deshanudara144-ui/Analog-Electronics-Project/Images/Final_Product.jpg

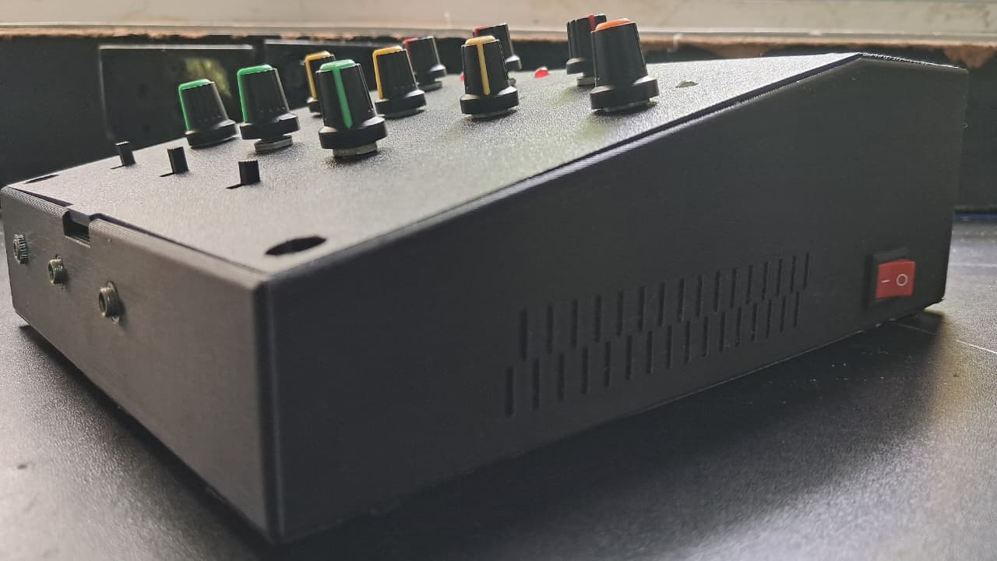
Images/Final_Product.jpg
