deshanudara144-ui/Analog-Electronics-Project/Images/PCB.jpg

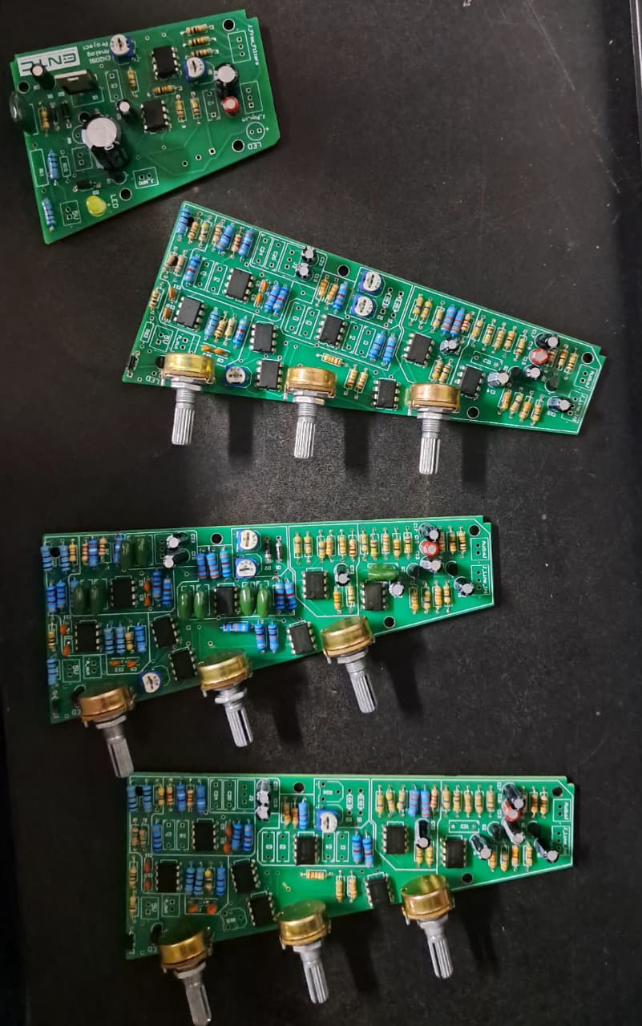
Images/PCB.jpg
