deshanudara144-ui/Analog-Electronics-Project/README.md

# 3-channel-audio-mixer
3 Channel Audio Mixer with 3 Band Equalizer – Electronics Engineering Project
# 3 Channel Audio Mixer with 3 Band Equalizer

This project presents the design and implementation of a 3 Channel Audio Mixer with a 3 Band Equalizer.

## Features
- Independent bass, mid, and treble control per channel
- Active RC filter-based equalization
- Operational amplifier based design
- Instrument and microphone input support
- Line-level audio output

## Applications
- Studio audio shaping
- Live sound systems
- Educational electronics projects

## Technologies Used
- Analog Electronics
- Operational Amplifiers
- Active Filters
- Audio Signal Processing

## Author
Udara Deshan  
BSc in Electronics Engineering  
University of Moratuwa
