deshanudara144-ui/Analog-Electronics-Project/Report/EN2091_Analog_project_Report.pdf

Department of Electronic & Telecommunication Engineering, University of Moratuwa, Sri Lanka.

# Three Channel Audio Mixer with Equalizers

Group Members:

Member 1 230130E | Deshan W.U.
Member 2 230138K | Dhananjaya K.T.G.T.N.
Member 3 230155J | Dissanaka D.M.D.P.
Member 4 230449N | Nuwanaka W.A.S.

Submitted in partial fulfillment of the requirements for the module EN 2091 Laboratory Practice and Projects

Date: December 14, 2025

Three Channel Audio Mixer with Equalizers | Circuit Pirates

Abstract
This project presents a compact analog audio mixer featuring three independent input channels, each equipped with a dedicated three-band equalizer—Bass (20–250 Hz), Mid (250 Hz–4 kHz), and Treble (4–20 kHz). The system enables precise tonal shaping of each channel through variable gain control stages, allowing users to amplify or attenuate specific frequency ranges according to acoustic needs. Signal processing is implemented using low-noise operational amplifiers (NE5532 and TL072), while the TDA2030A provides robust output amplification. BC547 transistors are employed for pre amplification. The mixer’s compact PCB layout ensures efficient signal routing and minimal footprint, making it suitable for portable and space-constrained applications. This design demonstrates practical applications of analog circuit principles, including multi-band filter design, signal mixing, component-level optimization, and system integration for real-world audio enhancement.

## Abbreviations and Acronyms

OpAmp Operational Amplifier

PCB Printed Circuit board

THD Total Harmonic Distortion

JFET Junction Field Effect Transistor

SNR Signal to noise ratio

1

## Contents

1 Introduction and Functionality | 3
2 System Architecture | 3
3 Component Selection | 7
4 PCB Design | 8
5 Enclosure Design | 10
6 Software Simulation and Hardware Testing | 12
7 Conclusion & Future Works | 14
8 Contribution of Group Members | 15

2

## 1 Introduction and Functionality

With the rapid growth of content creation among entry-level artists and the general public, the demand for compact, lightweight, and cost-effective audio mixers has increased significantly. Professional-grade sound mixers, although highly capable, are often expensive and bulky, making them unsuitable for beginners and small-scale applications.
To address this limitation, there is a growing need for portable and user-friendly audio mixing devices that offer essential audio processing features without excessive complexity. Audio mixers play a vital role in combining multiple audio sources and adjusting signal levels to achieve balanced and high-quality sound output.
The Three Channel Audio Mixer with Equalizers, developed by Circuit Pirates, is designed to fulfill this requirement. The system enables users to mix three independent audio inputs while providing equalization control to adjust low, mid, and high frequency components. This makes the mixer suitable for applications such as music recording, podcast production, live streaming, and educational audio experiments, where simplicity, affordability, and performance are equally important.

## 2 System Architecture

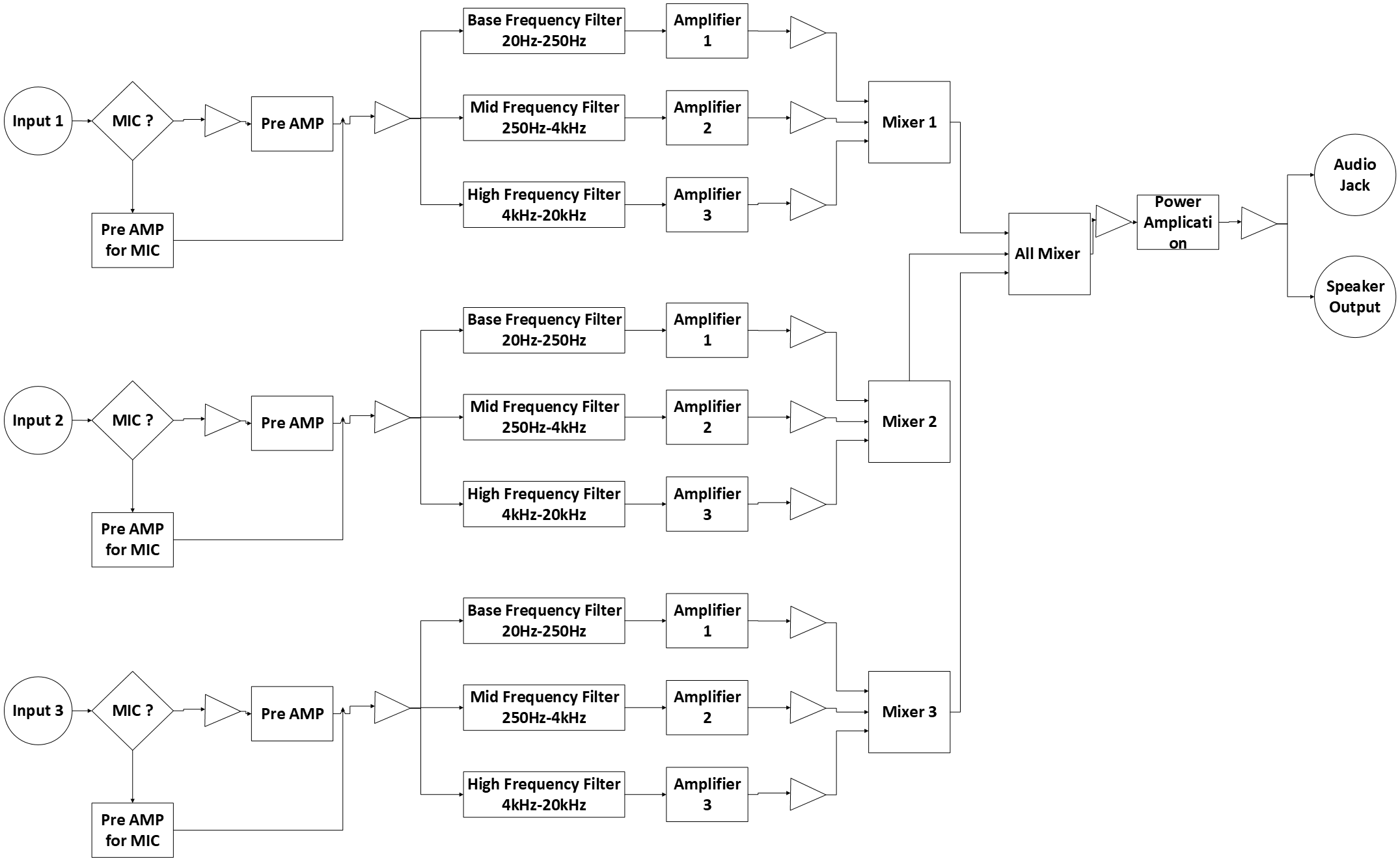
[picture p4: figure]

Figure 1: Example Figure.

### 2.1 Pre Amplifier

Mic Pre-amplifier

For the mic pre-amplifier we used a cascaded transistor based amplifier in common emitter configuration with voltage divider bias.This ensured the thermal stability and the preferred gain.(gain 160) Moderate input impedance and high output impedance was required by the mic input, this BJT configuration ensured these needs.

3

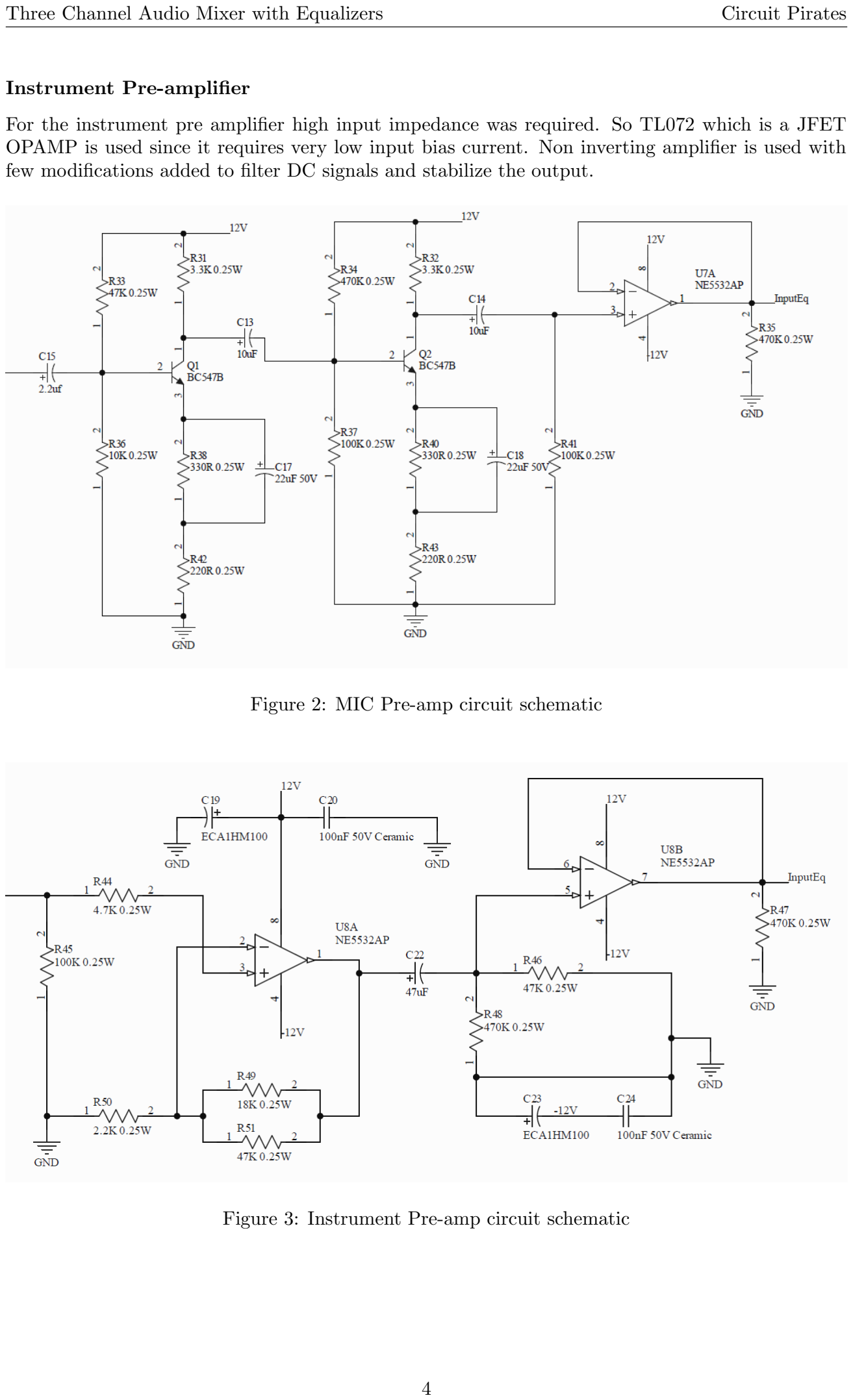
[picture p5: page 5]

Instrument Pre-amplifier

For the instrument pre amplifier high input impedance was required. So TL072 which is a JFET OPAMP is used since it requires very low input bias current. Non inverting amplifier is used with few modifications added to filter DC signals and stabilize the output.

Figure 2: MIC Pre-amp circuit schematic

Figure 3: Instrument Pre-amp circuit schematic

4

### 2.2 Equalizers

Unity gain band-pass filters are implemented by cascading a second-order Sallen–Key low-pass filter with a second-order Sallen–Key high-pass filter. This configuration enables independent adjustment of the lower and upper cutoff frequencies, thereby providing flexible control over the passband characteristics.

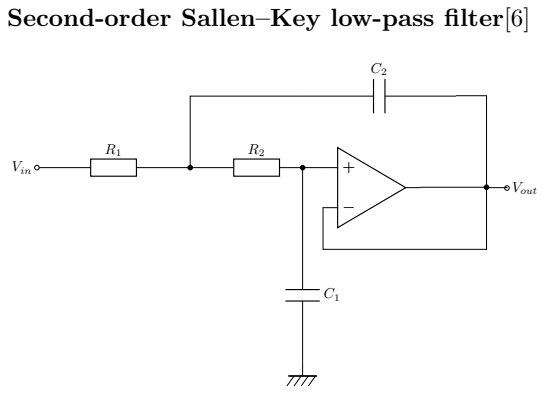
[picture p6: figure]
Second-order Sallen–Key low-pass filter[6]; Vin; Vout

Figure 4: Sallen–Key low-pass filter

- Cut-off frequency: fc =
1
2π

√
R1R2C1C2
- Dumping factor: ζ =
R1+R2
2

q C1

C2R1R2

- Filter quality: Q =
ζ
2

By selecting R1 = R2 = R and C1 = C2 = C, the cutoff frequency simplifies to

fc =

1
2πRC .

Furthermore, under these conditions, the damping factor is ζ = 1, corresponding to a critically damped response, and the quality factor is Q = 0.5.

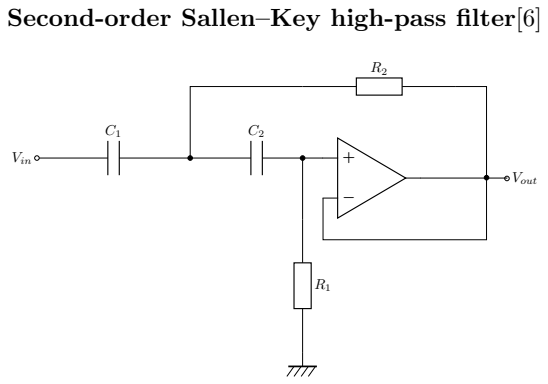
[picture p7: figure]
Second-order Sallen–Key high-pass filter[6]; Vin; Vout

Figure 5: Sallen–Key high-pass filter

- Cut-off frequency: fc =
1
2π

√
R1R2C1C2
- Dumping factor: ζ =
C1+C2
2

q R2

R1C1C2

- Filter quality: Q =
ζ
2

Similar to the low-pass filter, by selecting R1 = R2 = R and C1 = C2 = C, the cutoff frequency of the high-pass filter simplifies to

fc =

1
2πRC .

Then again, under these conditions, the damping factor is ζ = 1, corresponding to a critically damped response, and the quality factor is Q = 0.5.

The above high-pass and low-pass filters are cascaded to form the unity gain band-pass filter.

5

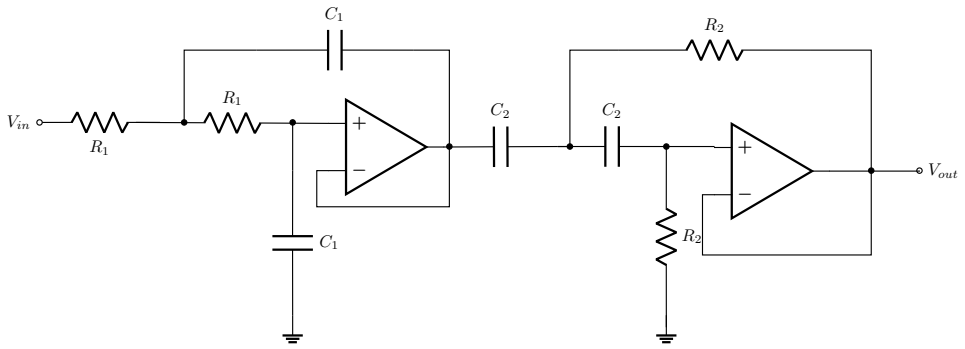
[picture p8: figure]
C2 Vin; Vout

Figure 6: Unity-Gain Sallen-Key Band-Pass Filter

Calculated Theoretical Resistor & Capacitor Values for Band-pass Filters

Frequency band | Low pass filter | High pass filter
| R1 C1 | R2 C2
Low frequency band (50 Hz – 250 Hz) | 6.2 kΩ 100 nF | 33 kΩ 100 nF
Mid frequency band (250 Hz – 4 kHz) | 3.9 kΩ 10 nF | 6.2 kΩ 100 nF
High frequency band (4 kHz – 20 kHz) | 820 Ω 10 nF | 3.9 kΩ 10 nF

Table 1: Component values for band-pass filters

However, slight variations were observed between the practical resistor and capacitor values and the theoretically calculated values, primarily due to component tolerances.

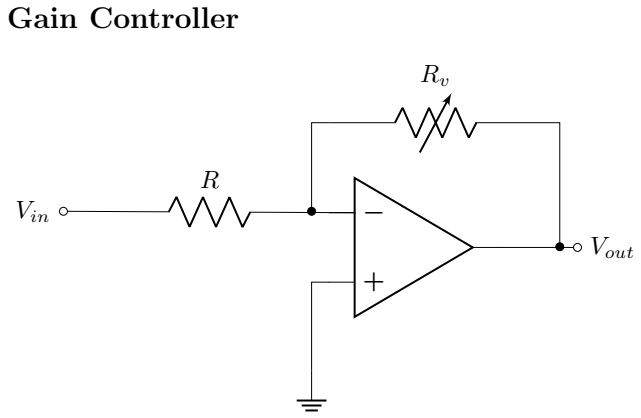
[picture p9: figure]
Gain Controller; Vin; Vout

figure: Gain Controller

Vin − 0
R

=

0 − Vout
Rv

Vout =

Rv
R

Vin

6

### 2.3 Power Amplifier Design

The power amplifier circuit was taken from the datasheet of the TDA2030A IC by ST Microelectronics.[5]

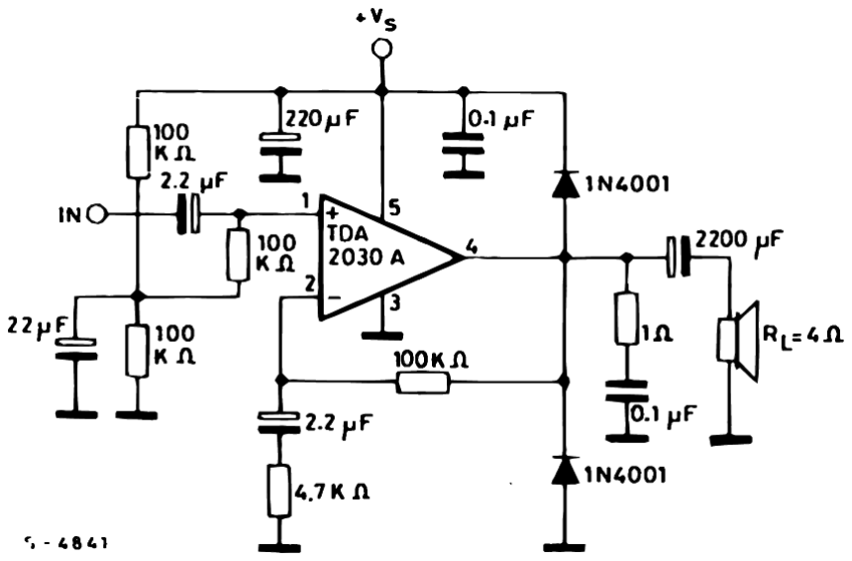
[picture p10: figure]

Figure 7: Power apmplifier circuit design.

### 2.4 Power supply

12V dual supply was designed. Additionally coupling capacitors were added to remove the ripple.

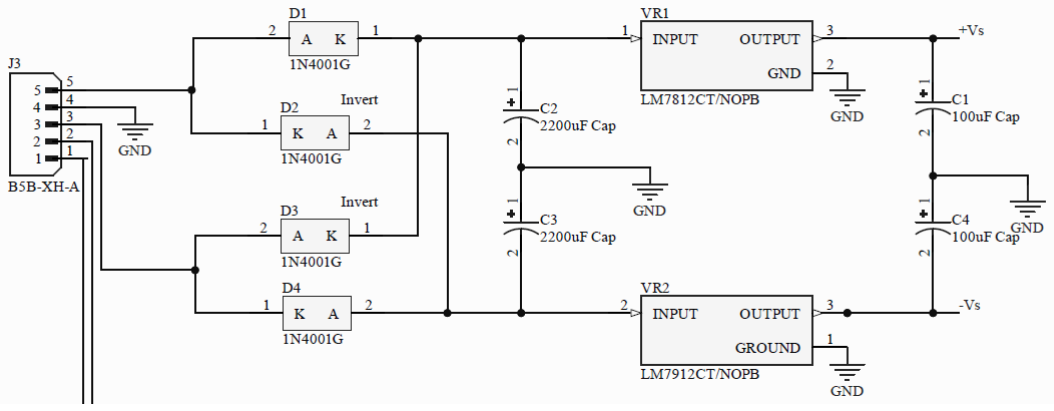
[picture p11: figure]

Figure 8: Power supply circuit design.

## 3 Component Selection

1. BC547B NPN Transistor (Audio Applications) [4]
- Low Noise BJT: Suitable for small-signal audio preamplifiers
- Low Input Noise Current: Ideal for microphone and sensor front-ends
- High Gain (hFE): 200–450 typical for clean signal amplification
- Low Distortion: Works well in linear amplifier stages
- Collector Current: Up to 100 mA for small audio drivers
- Common Use: Input stages, tone controls, preamp gain blocks

7

2. NE5532 Dual Low-Noise Audio Operational Amplifier [3]
- Ultra-Low Noise: 5 nV/√
Hz for high-fidelity audio
- Low THD: 0.0005% typical for clean reproduction
- High Slew Rate: 9 V/µs supports wide dynamic range
- Wide Bandwidth: 10 MHz GBW for full audio spectrum accuracy
- High Output Drive: Can directly drive 600 Ω loads
- Common Use: Headphone amps, mixers, equalizers, DAC/ADC buffers
3. TL072 JFET-Input Audio Operational Amplifier [2]
- JFET Inputs: Very high input impedance for guitar/piezo pickups
- Low Noise: 15 nV/√
Hz suitable for musical instrument preamps
- High Slew Rate: 16 V/µs for fast transient response
- Low Distortion: 0.01% typical across audio band
- Warm JFET Sound: Preferred in analog synths and guitar pedals
- Common Use: Tone shaping, buffers, active filters, effects pedals
4. TDA2030A Class-AB Audio Power Amplifier [5]
- Output Power: Up to 20W for compact speaker systems
- Low THD: Very low harmonic and crossover distortion
- High Output Current: Drives 4 Ω and 8 Ω speakers
- Wide Frequency Response: Suitable for full-range audio
- Stable Class-AB Operation: Smooth, warm analog sound
- Common Use: Active speakers, subwoofer modules, DIY amplifiers

## 4 PCB Design

We implemented a modular approach where we used 3 separate PCB s for the channels and a single PCB to combine and power amplify the signal. The power supply was made as a separate PCB to reduce the power supply noise interference with audio.

Signal Integrity and Noise Reduction

The PCB layout was created with a focus on reducing noise and maintaining signal integrity. Sensitive input paths were routed away from switching or high-current nodes, and low-level audio traces were kept as brief as possible to minimize interference.

Grounding Strategy

To avoid ground loops and get a clear audio performance, a star-ground strategy was used. Analog grounds for each channel were separated throughout the board and joined only at a single point.

Power Supply and Decoupling

Each channel was provided with local decoupling capacitors, combining 100 nF ceramic capacitors for high-frequency filtering and 10 µF electrolytic capacitors for reducing low-frequency voltage ripple. The power supply section was physically isolated from the audio signal paths, ensuring clean ±12 V rails for the mixer.

8

Component Placement and Routing

In order to support both mechanical usability and electrical performance, component placement was optimised. To reduce loop area, op-amps were positioned near their corresponding feedback networks. Potentiometers were positioned for front-panel mounting, and input connectors were placed close to the preamplifier stage to minimise trace length. Thinner traces were used for low-level audio signals, and wider traces were used for power and output paths.

Thermal and Mechanical Considerations

Thermal considerations were taken into consideration even though the mixer mostly uses low-power analogue components. To enable heat dissipation, components like output drivers and voltage regulators were positioned close to the board’s edges. We used a cooling fan to maximize the air flow and hence effectively cool down the power amplifier and voltage regulator ICs.

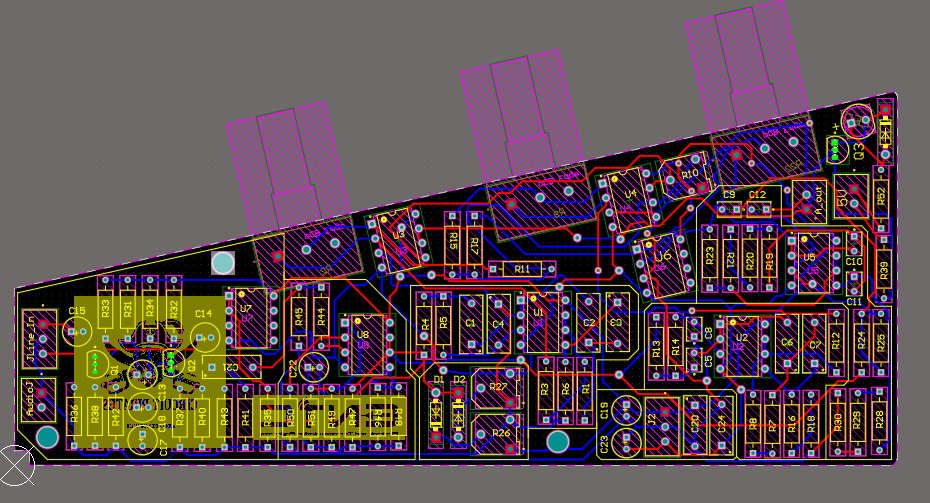
[picture p12: figure]

Figure 9: Routing diagram of channel equalizer,

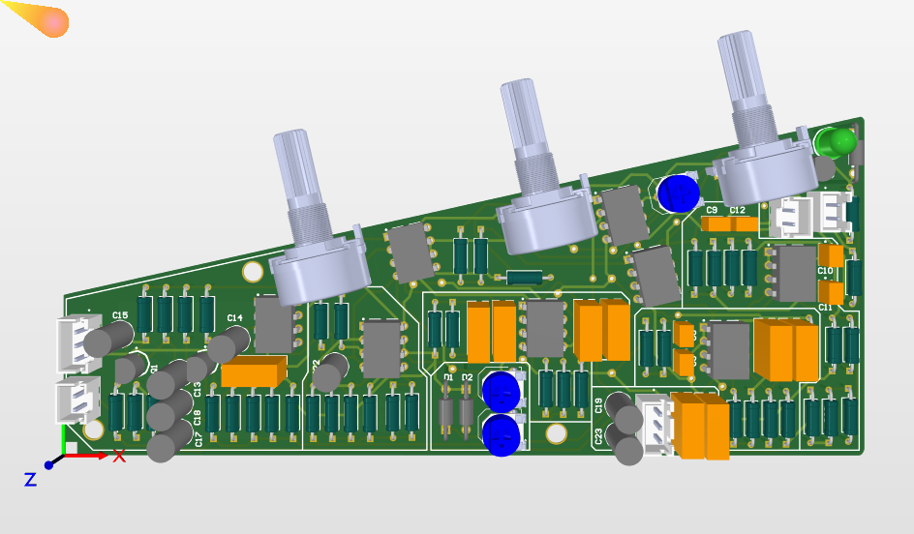
[picture p13: figure]

preamplifier PCB. | Figure 10: 3D diagram of channel equalizer, pre amplifier PCB.

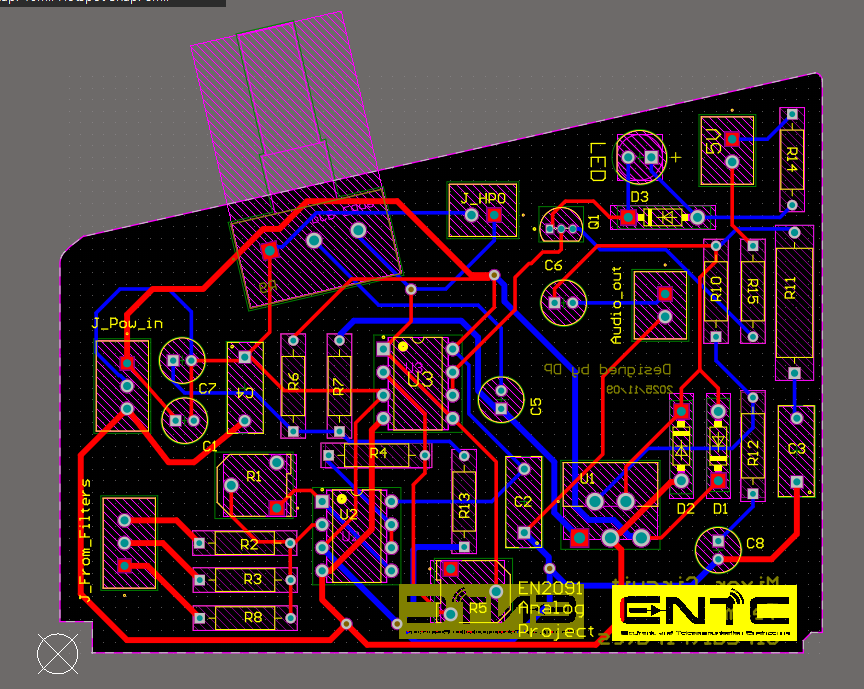
[picture p14: figure]

Figure 11: Routing diagram of channel mixer, power amplifier PCB.

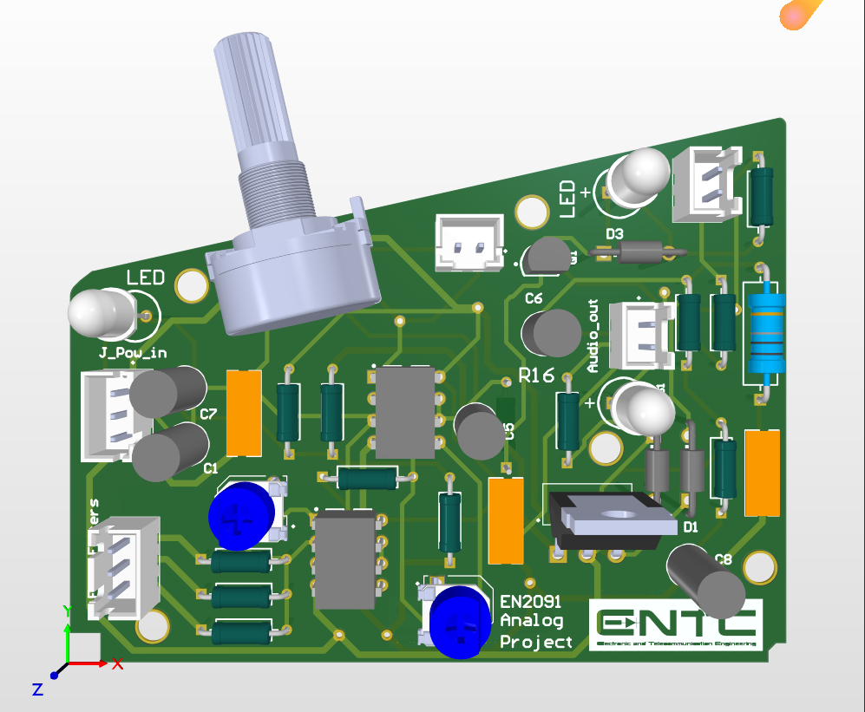
[picture p15: figure]

Figure 12: 3D diagram of channel equalizer, preamplifier mixer, power amplifier PCB.

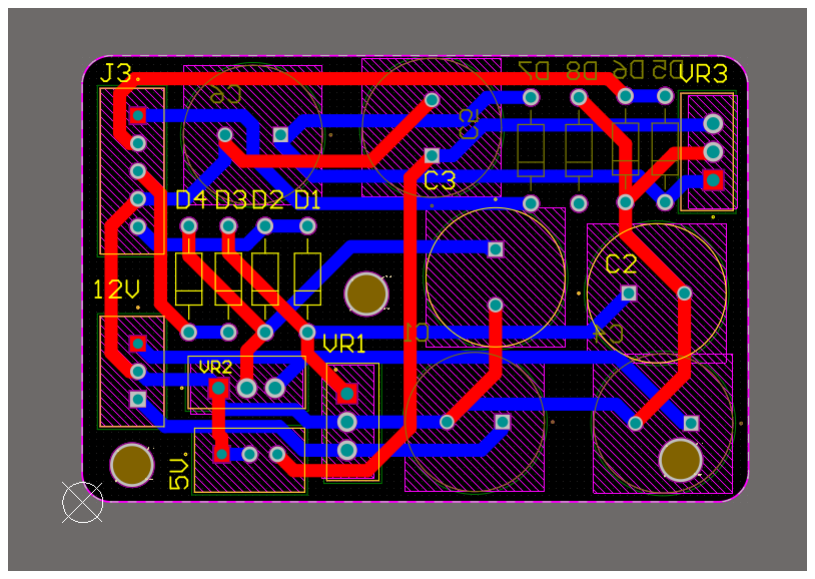
[picture p16: figure]

Figure 13: Routing diagram of channel power supply PCB.

Figure 14: 3D diagram of channel power supply PCB.

9

## 5 Enclosure Design

The enclosure was designed to protect the electronic components from mechanical damage and to electrically isolate them from the user. The overall dimensions of the enclosure are 17.5 cm in width and 22.5 cm in length. The height of the shorter side is 3.6 cm, while the taller side has a height of 7.0 cm. A wall thickness of 3 mm was selected to increase the mechanical strength and rigidity of the enclosure.
A space with dimensions of 7 cm × 17.5 cm and a constant height of 7.0 cm was reserved for placing the transformer and the cooling fan. All PCBs, except the power supply PCB, were mounted vertically inside the enclosure and secured using screws.

Ventilation holes were provided on both the left and right sides, as well as on the rear side of the enclosure, to facilitate adequate airflow and heat dissipation. Polylactic Acid (PLA) was selected as the material for 3D printing.

To reduce the overall 3D printing cost, two bottom support structures were printed as separate components and subsequently attached to the enclosure during assembly.

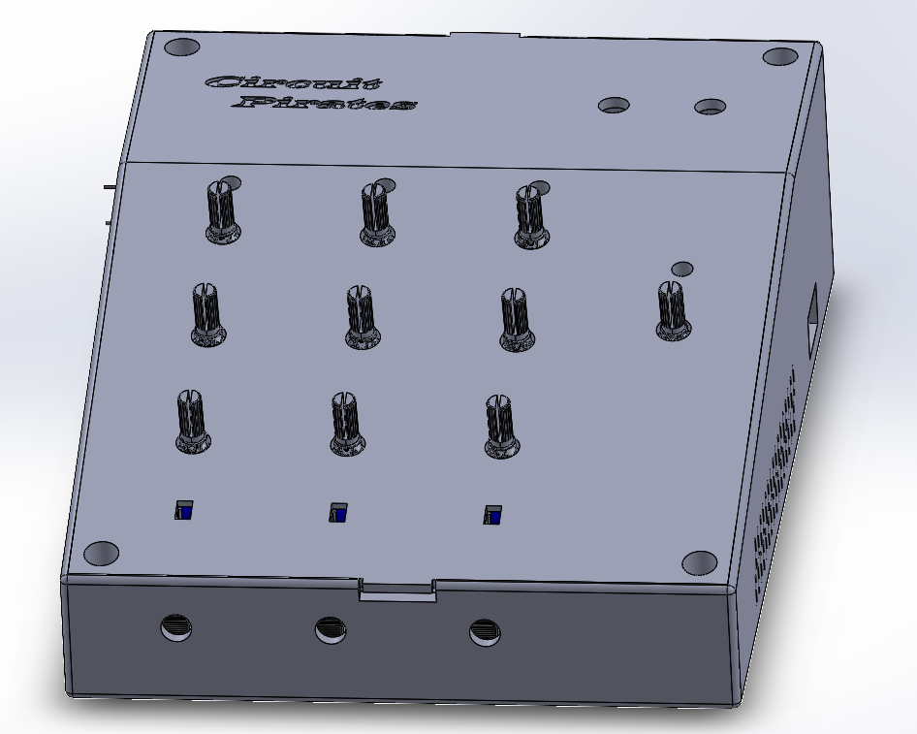
[picture p17: figure]

Figure 15: Enclosure front view

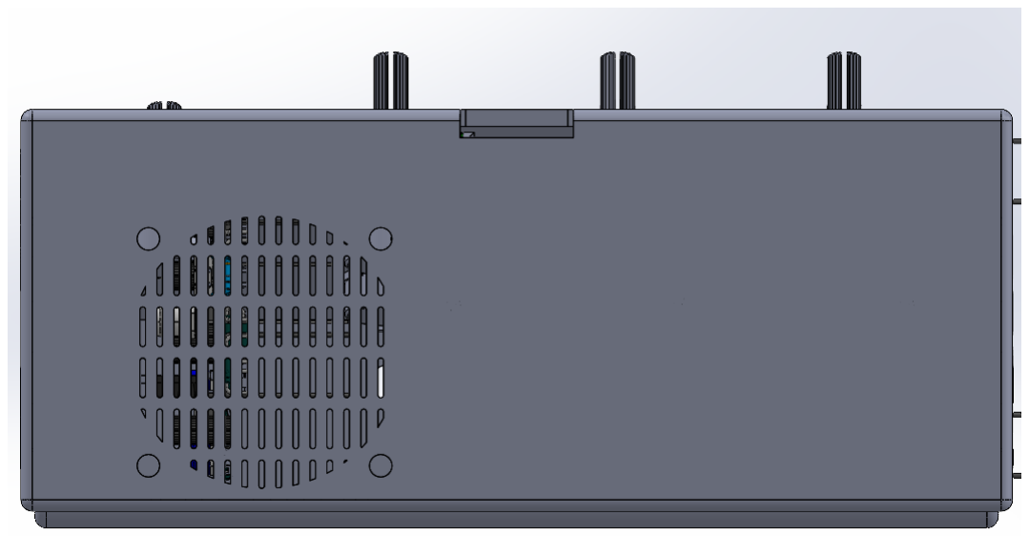
[picture p18: figure]

Figure 16: Back view

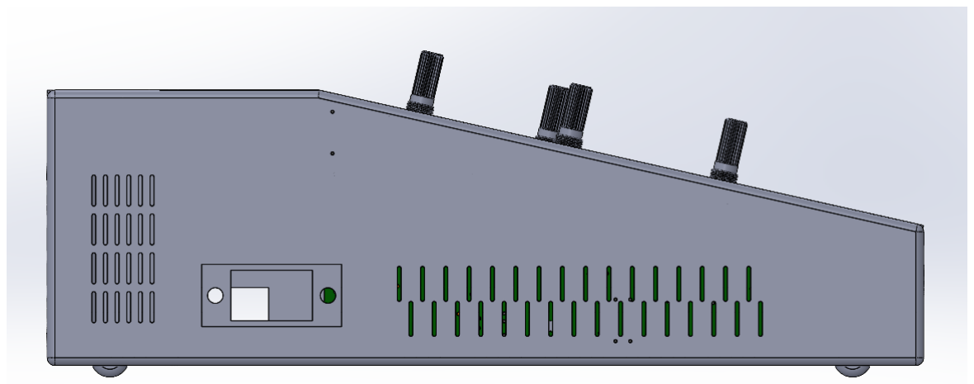
[picture p19: figure]
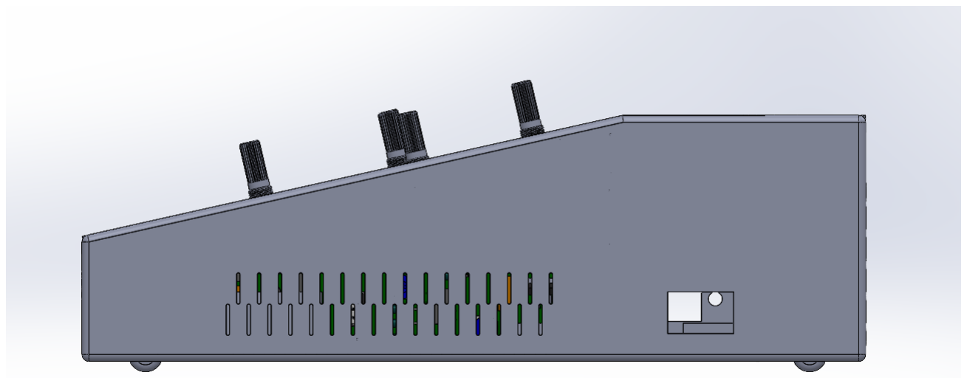
[picture p20: figure]

Figure 17: Right side view | Figure 18: Left side view

10

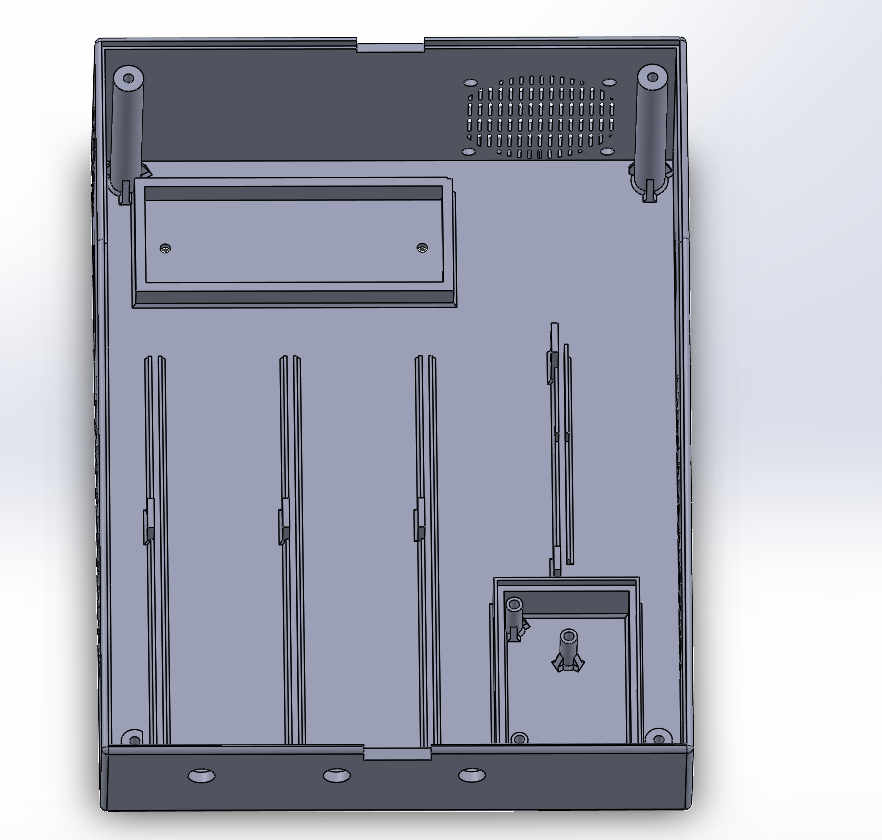
[picture p21: figure]

Figure 19: Inside view

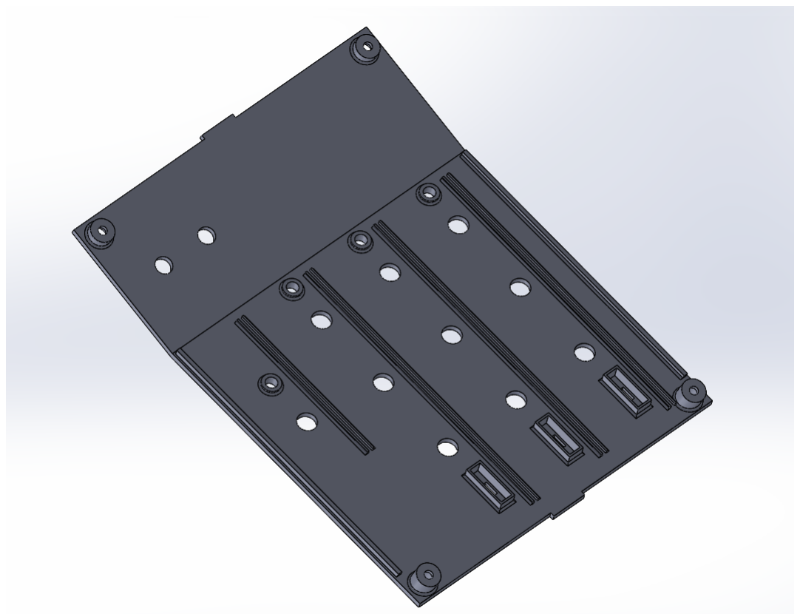
[picture p22: figure]

Figure 20: Lid

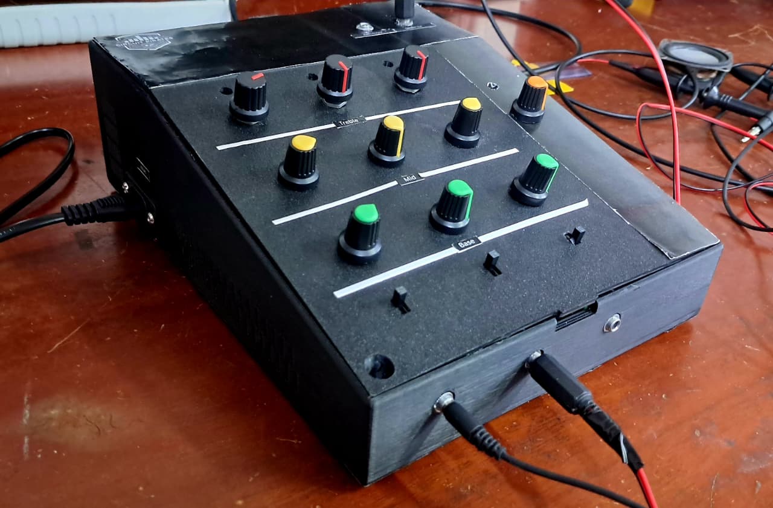
[picture p23: figure]

Figure 21: Final product

11

## 6 Software Simulation and Hardware Testing

### 6.1 Software simulation

Software simulation was done with LTspice software. Pre amplifier, filter circuits were tested individually and combined later.

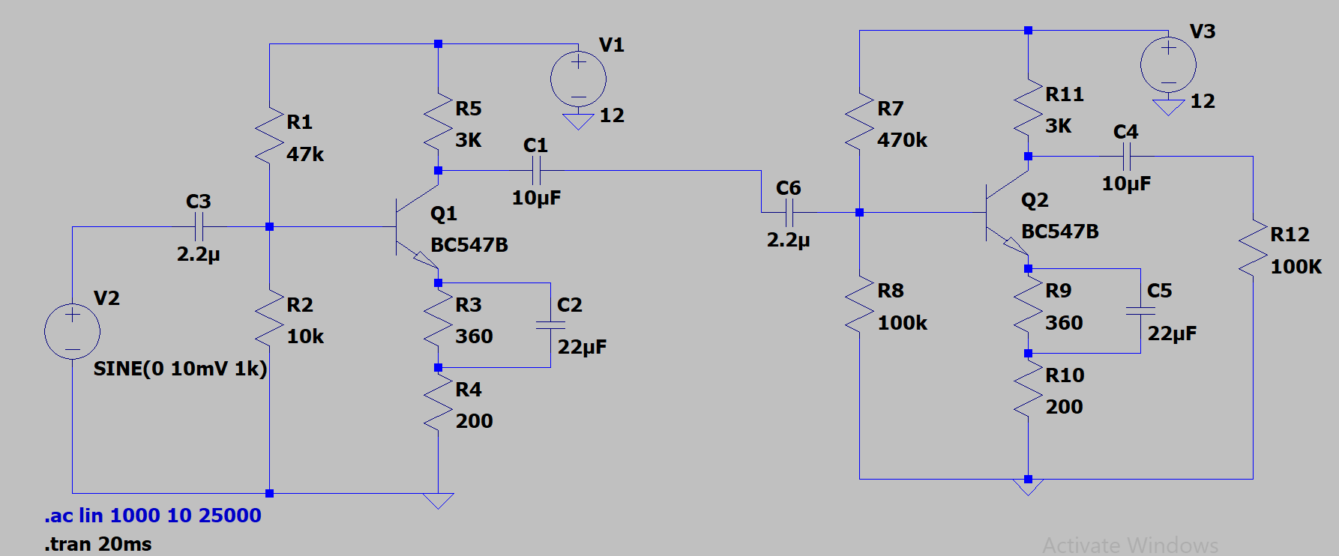
[picture p24: figure]
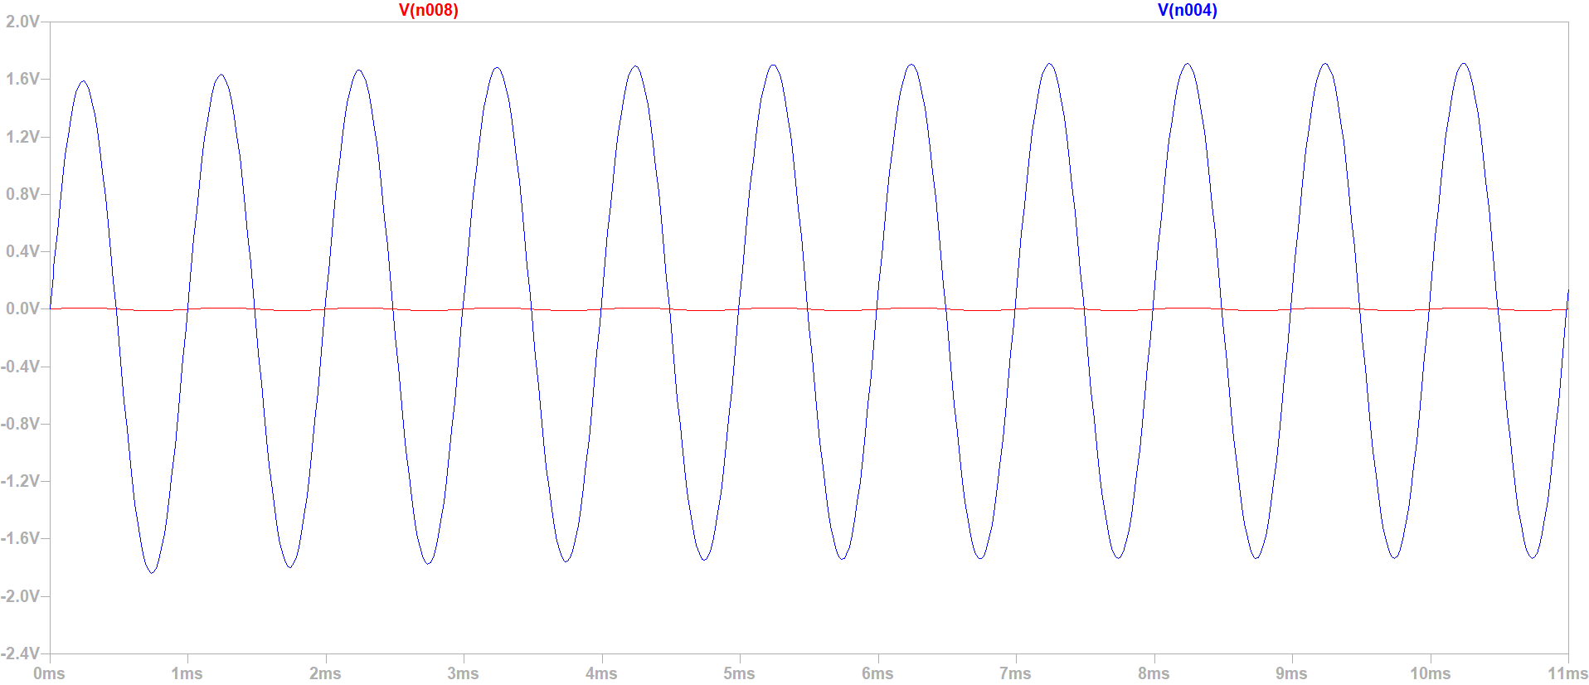
[picture p25: figure]

Figure 22: Pre amplifier circuit | Figure 23: LT spice simulation output.

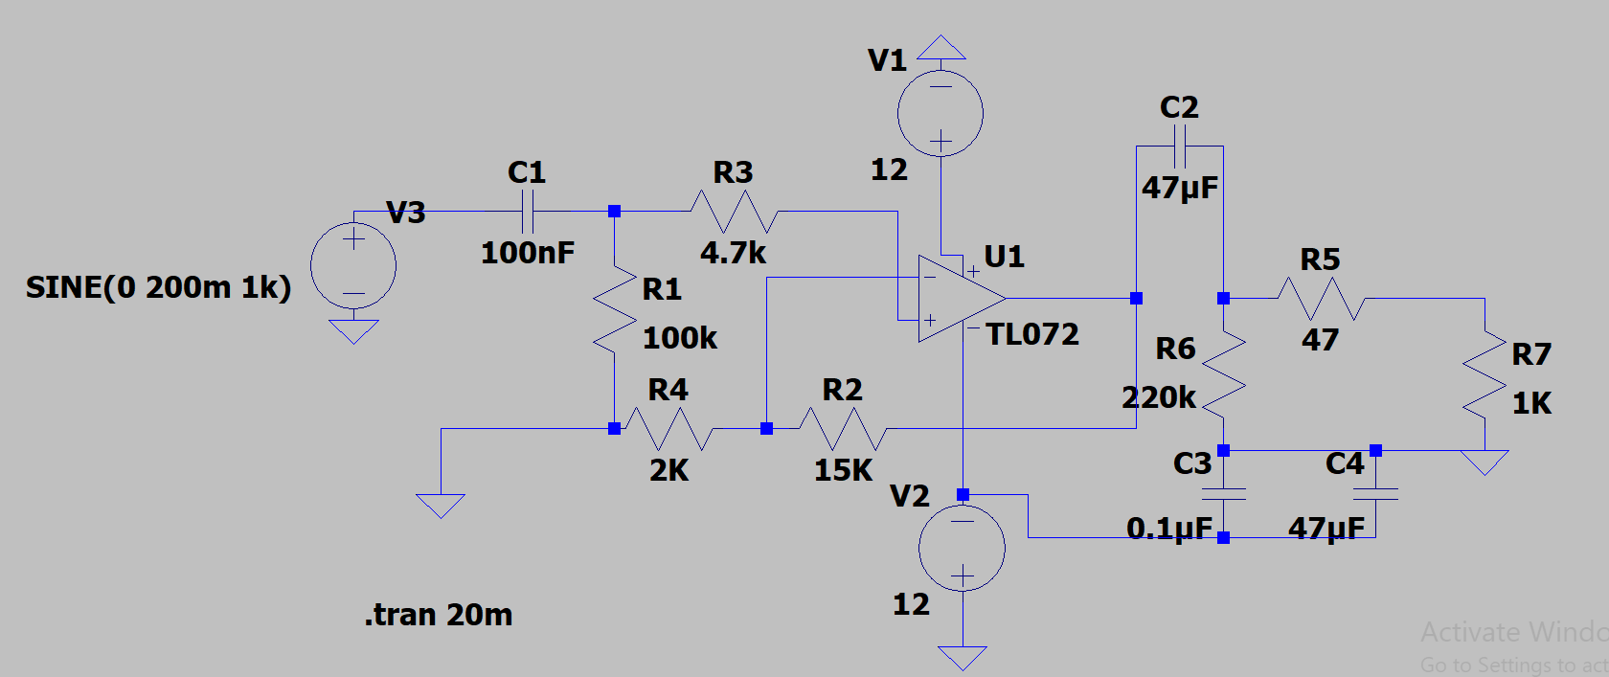
[picture p26: figure]
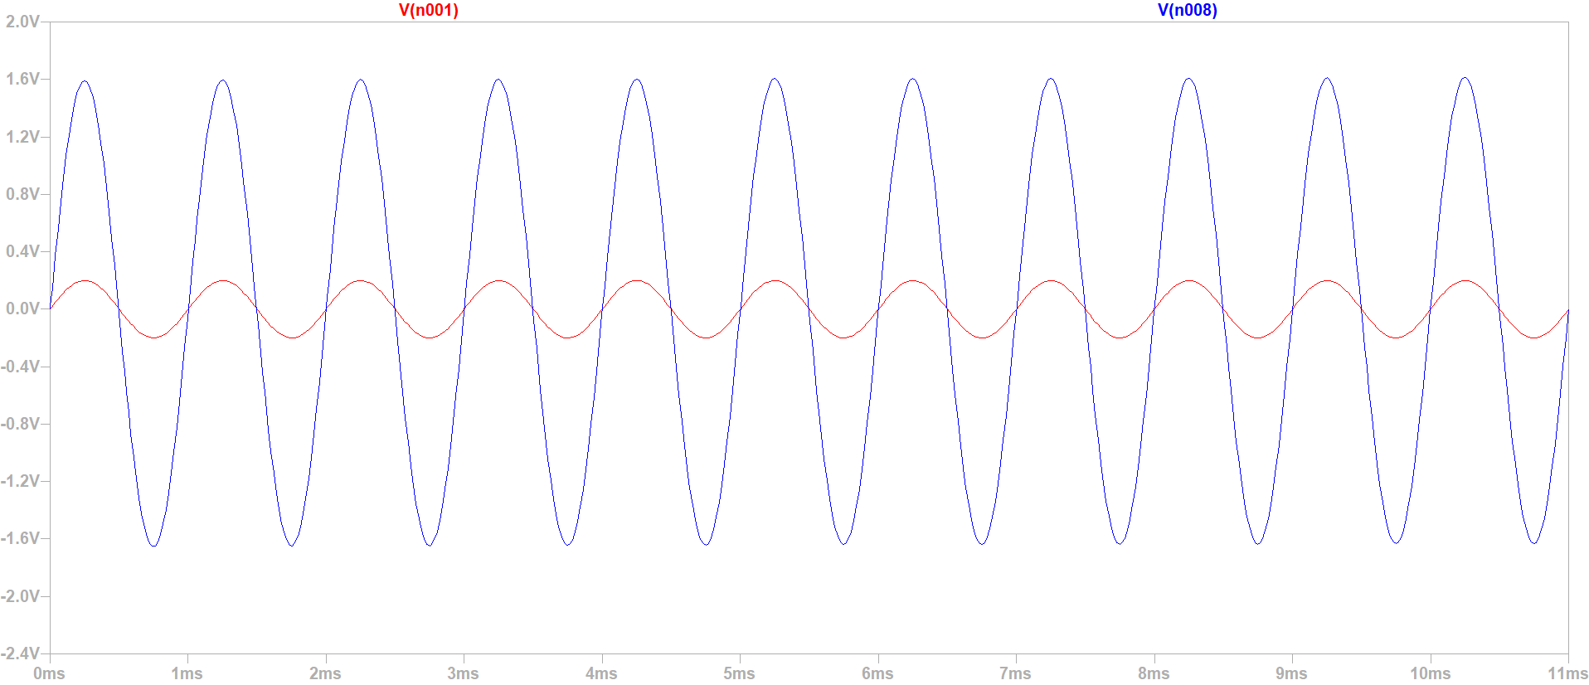
[picture p27: figure]

Figure 24: Pre amplifier circuit for instruments. | Figure 25: LT spice simulation output.

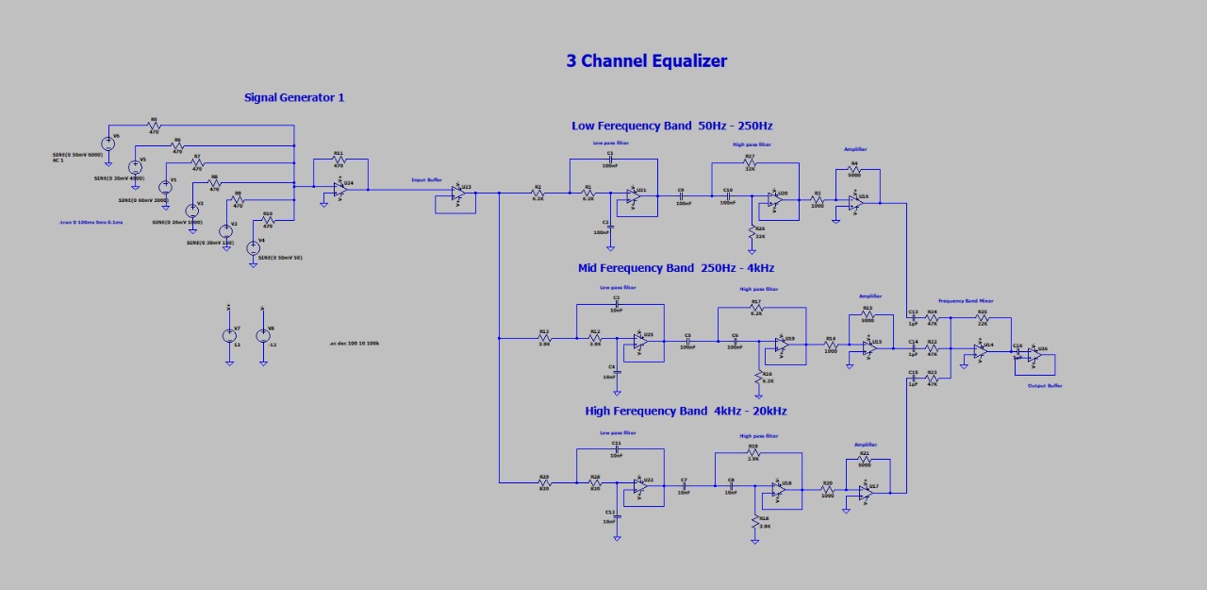
[picture p28: figure]

Figure 26: Equalizer LTspice simulation

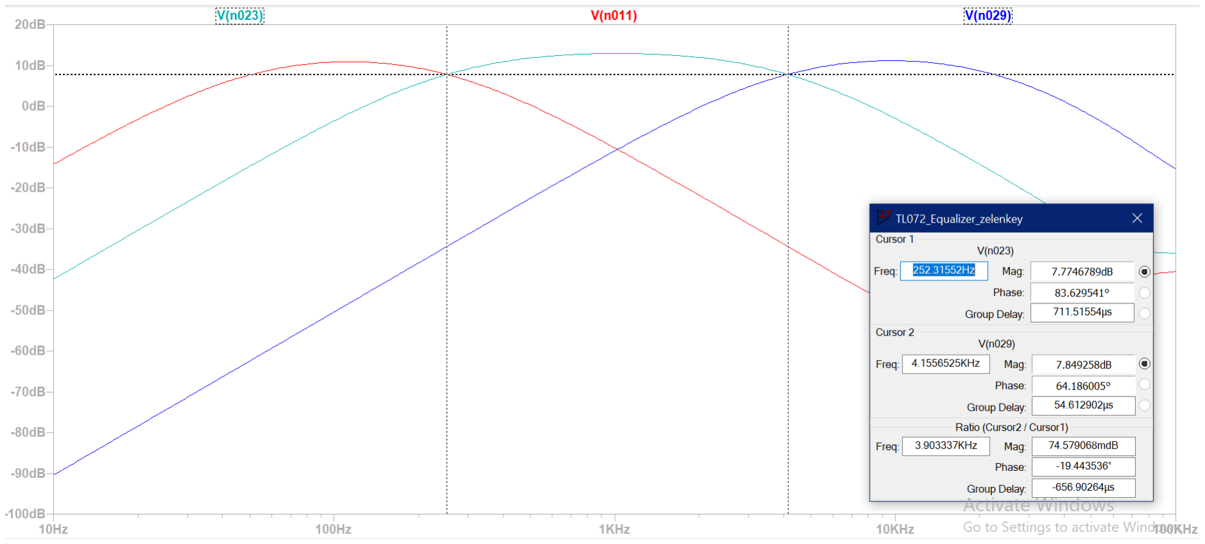
[picture p29: figure]

Figure 27: LT spice simulation frequency response for each frequency band.

12

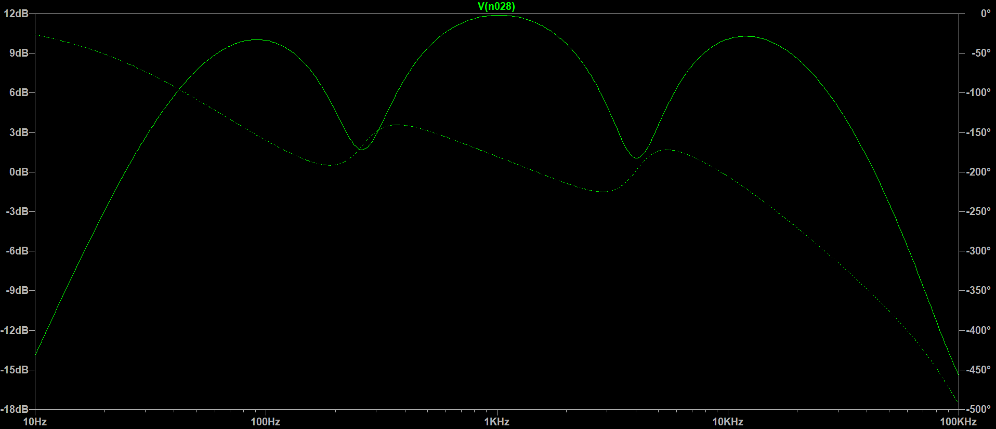
[picture p30: figure]

Figure 28: Equalizer Frequency response.

### 6.2 Hardware Testing

Hardware testing was carried out in two stages, first we implemented the circuits on breadboards and validated the design. Second testing was done to ensure the PCB implementation is error free.

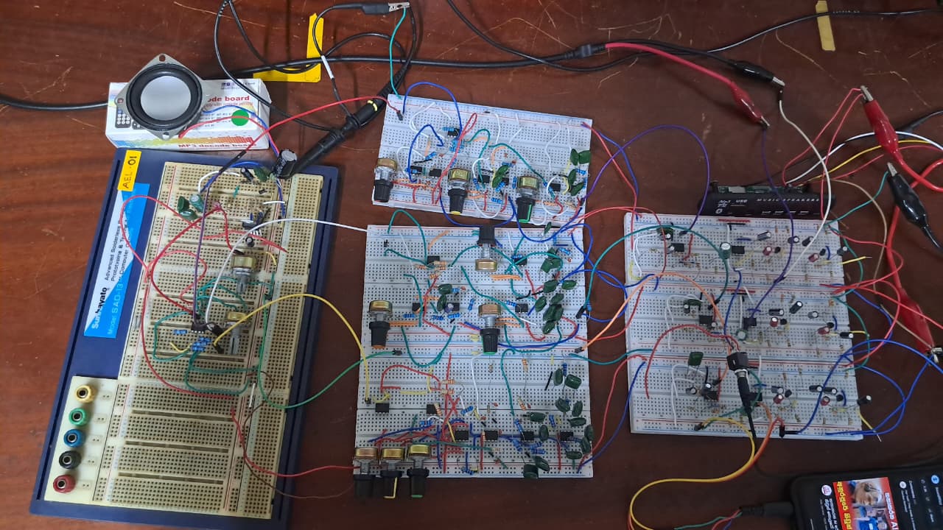
[picture p31: figure]

Figure 29: Breadboard testing.

13

## 7 Conclusion & Future Works

Conclusion

In this project, a 3-Channel Audio Mixer with a 3-Band Equalizer was successfully designed and implemented. The system allows independent control of low, mid, and high frequency bands for each input channel, providing flexibility in audio mixing and tone shaping. By using operational amplifiers, active RC filter networks, and proper buffering techniques, the mixer achieves stable operation with minimal distortion and acceptable noise performance.
The mixer effectively combines multiple audio inputs into a single output while maintaining signal integrity. The practical implementation validated the theoretical design concepts studied in analog electronics, such as filter design, gain control, and signal summing. Testing results confirmed that the equalizer provides noticeable frequency adjustment and the overall system performs reliably for basic audio applications such as small audio setups, educational demonstrations, and laboratory use.
This project enhanced our understanding of analog audio signal processing, circuit debugging, PCB layout considerations, and real-world implementation challenges.

Future Work

Although the current design meets the project objectives, several improvements can be considered for future development:
Class-D Power Amplifier Integration: The current system uses a Class-AB power amplifier, which provides good audio quality but has relatively lower efficiency and higher power dissipation. In future versions, a Class-D power amplifier can be implemented to significantly improve power efficiency, reduce heat generation, and enable compact and portable designs. Additional Channels: Expanding the design to support more input channels for advanced mixing applications. Balanced Inputs and Outputs: Implementing balanced XLR or TRS connectors to reduce noise and interference in professional audio environments. Power Supply Enhancement: Designing a regulated and isolated power supply to further reduce hum and noise. User Interface Improvements: Adding LED level indicators or VU meters to visually monitor signal levels. Enclosure Optimization: Improving mechanical design for better portability, durability, and thermal management. Bluetooth or USB Audio Support: Adding wireless or USB audio interfaces for modern connectivity. With these enhancements, the audio mixer can be transformed into a more versatile and professional-grade audio processing system suitable for wider real-world applications.

14

## 8 Contribution of Group Members

Student’s Name (Index No.) | Contribution
K.G.T.N. Dhananjaya (230138K) | Circuit design, Circuit simulation, Enclosure design, Filter calcu-lations
W.U. Deshan (230130E) | Breadboard implementation, Circuit design, Testing, Soldering, Assembling
D.M.D.P. Dissanayaka (230155J) | PCB design, Testing, debugging, Circuit design, Breadboard im-plementation
W.A.S. Nuwanaka (230449N) | Breadboard implementation, Testing, Soldering, Assembling

## Acknowledgment

We would like to express our sincere gratitude to all those who supported and guided us throughout the completion of this group project. We are deeply thankful to Dr. Sampath Perera for his valuable insights, encouragement, and continuous guidance, which greatly contributed to the quality of our work. We also extend our appreciation to Ms. Sanjana Kapukotuwa for the constructive feedback, technical assistance, and willingness to share their expertise whenever needed. Finally, we wish to thank the lab technicians for their support, service, and cooperation during the various stages of this project. Their collective contributions have been instrumental in the successful completion of our work.

## References

[1] Texas Instruments, Designing professional audio mixers for every scenario, Rev. 8, Advanced Analog Products, SLOD006B, 2018. [Online]. Available: https://www.ti.com/lit/wp/spry322/spry322.pdf?ts=1765656390235
[2] Texas Instruments,TL072 — Dual, 30-V, 3-MHz, low-noise JFET-input operational amplifier,” TI product page (Datasheet TL07xx family), [Online]. Available: https://www.ti.com/lit/ds/symlink/tl072.pdf
[3] Texas Instruments, “NE5532 — Dual, 30-V, 10-MHz, low-noise operational amplifier for audio applications,” TI product page (Datasheet Rev. J), Jan. 27, 2015. [Online]. Available: https: //www.ti.com/product/NE5532
[4] “BC547 — NPN, low-noise general-purpose transistor,” ON Semiconductor product page (Datasheet BC546/BC547/BC548 series), [Online]. Available: https://cdn.sparkfun.com/assets/d/5/e/5/d/BC547.pdf
[5] “TDA2030A — 18-W, class-AB audio power amplifier,” STMicroelectronics product page (Datasheet Rev. 3), [Online]. Available: https://mm.digikey.com/Volume0/opasdata/d220001/medias/docus/1/TDA2030A.pdf
[6] S. Winder, ”Analog and Digital Filter Design”, 2nd ed. Oxford, U.K.: | Newnes,
2002. | Available: | https://www.sciencedirect.com/book/monograph/9780750675475/
analog-and-digital-filter-design

15
