deshanudara144-ui/Analog-Electronics-Project/Images/Encloser_Inside.jpg

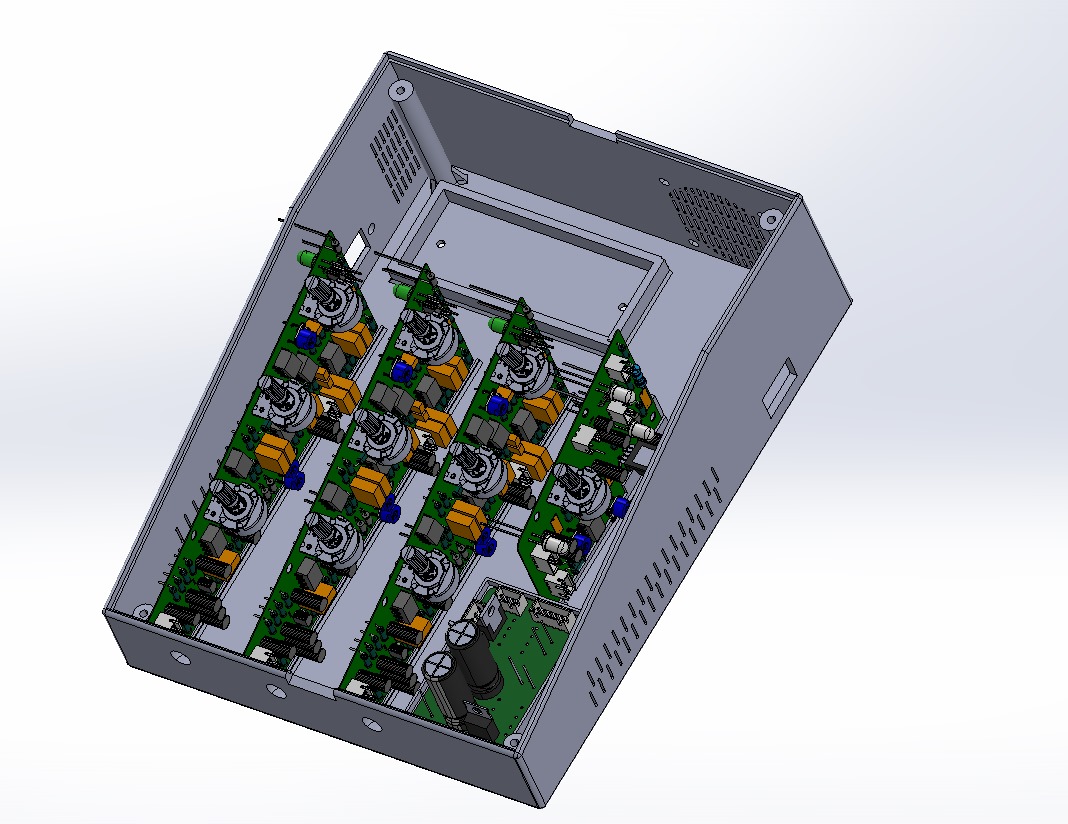
Images/Encloser_Inside.jpg
