deshanudara144-ui/Analog-Electronics-Project/Images/Final_Product_.jpg

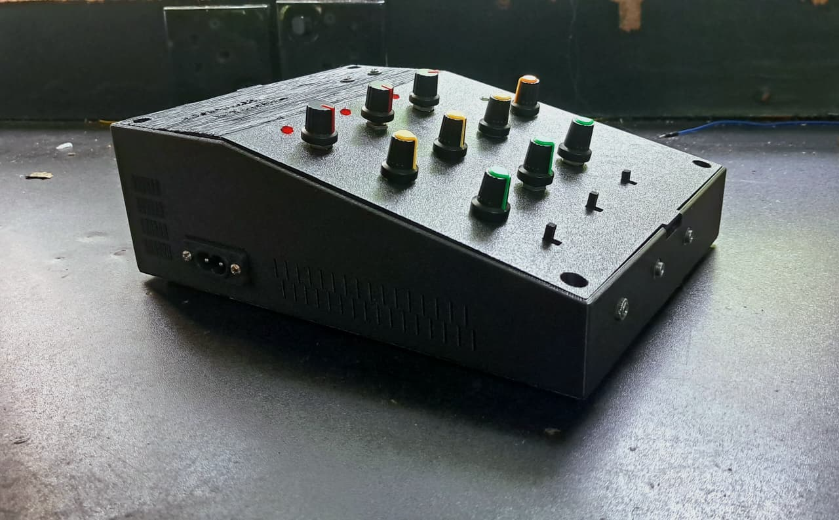
Images/Final_Product_.jpg
