deshanudara144-ui/Analog-Electronics-Project/Simulation/Simulation.asc

C1: cap; 10µF
C2: cap; 22µF
C3: cap; 2.2µ
C4: cap; 10µF
C5: cap; 22µF
C6: cap; 2.2µ
C13: cap; 100nF
C14: cap; 100nF
C15: cap; 10nF
C16: cap; 10nF
C17: cap; 100nF
C18: cap; 100nF
C19: cap; 10nF
C20: cap; 10nF
C21: cap; 100nF
C22: cap; 100nF
C23: cap; 10nF
C24: cap; 10nF
Q1: npn; BC547B
Q2: npn; BC547B
R1: res; 47k
R2: res; 10k
R3: res; 360
R4: res; 200
R5: res; 3K
R6: res; 100K
R7: res; 470k
R8: res; 100k
R9: res; 360
R10: res; 200
R11: res; 3K
R19: res; 6.8k
R20: res; 6.8k
R21: res; 10K
R22: res; 10K
R23: res; 4.7K
R29: res; 2k
R30: res; 3.3K
R31: res; 3.3K
R32: res; 6.8k
R33: res; 10K
R34: res; 6.2K
R35: res; 6.2K
R36: res; 2.47k
R37: res; 2.47k
R38: res; 1000
R39: res; 5000
R40: res; 22K
R41: res; 22K
R42: res; 22K
R43: res; 66K
R44: res; 32K
R45: res; 33k
R46: res; 680
R47: res; 680
R145: res; 100K
U1: TL072
U2: TL072
U4: TL072
U5: TL072
U6: TL072
U7: TL072
U8: TL072
U9: TL072
U10: TL072
U11: TL072
U12: TL072
U13: TL072
U14: TL072
V2: voltage; SINE(0 50mV 50)
V13: voltage; 12
V14: voltage; -12
Named nets: 0, V+, V-
Signal Input
Low pass filter
Gain Control
Low Ferequency Band  50Hz - 250Hz
Low pass filter
Gain Control
Mid Ferequency Band  250Hz - 4kHz
High pass filter
High pass filter
Gain Control
High Ferequency Band  4kHz - 20kHz
Input Buffer
3 Channel Equalizer
Frequency Band Mixer
High pass filter
Low pass filter
MIC pre amplifier (2mV -10 mV)
Instrument pre amplifier(100mV-200mV)
Channel 1
Power supply
3 Channel Equalizer
.tran 10m
